jankralx/hapcan_cc_led_driver/docs/notes.md

final design should go with these components as find out on the prototype measurements:
- MSD1514-473MED Coilcraft common mode coils
- FDMS86252 as the tranzistor
- V3N103-M3/I as the main diode

however these components are for the parameters that were originally provided for the design without any specific tooling
there might be changes needed if the design parameters are changed or simulations show a different behaviour
