jankralx/hapcan_cc_led_driver/kicad/cc_led_driver_prototype/hapcan_cc_led_driver.csv

Id | Designator | Footprint | Quantity | Designation | Supplier and ref
1 | C1, C4, C6, C7, C11, C12 | C_1210_3225Metric | 6 | 4u7/100V KAM32LR72A475KU
2 | C2 | C_0805_2012Metric | 1 | 220n
3 | C3, C5, C13 | C_Elec_6.3x5.8 | 3 | 56uF/63V PCV1J5R6MCL1GS
4 | C8, C9 | C_1210_3225Metric | 2 | 1u/100V X7R
5 | C10 | C_Rect_L28.0mm_W10.0mm_P22.50mm_MKS4 | 1 | 10u/100V B32523Q1106K
6 | D1 | D_SMB | 1 | SM6T33A
7 | D2 | D_MiniMELF | 1 | BZV55B3V3
8 | D3 | TO-277A | 1 | MBR5H150PC-AU
9 | F1 | C_Disc_D9.0mm_W2.5mm_P5.00mm | 1 | 0ZRS0500FF1A
10 | J1, J3 | PhoenixContact_MSTBA_2,5_2-G-5,08_1x02_P5.08mm_Horizontal | 2 | Conn_01x02_Socket
11 | J2 | PinHeader_1x02_P2.54mm_Vertical | 1 | Conn_01x02_Socket
12 | L1 | L_CommonModeChoke_Bourns_SRF1260 | 1 | SRF1280A-470M
13 | Q1 | TO-252-2 | 1 | PJD45N15S-AU_L2_006A1
14 | R1, R5, R14 | R_0805_2012Metric | 3 | 12k
15 | R2 | R_0805_2012Metric | 1 | 2R2
16 | R3, R4, R10 | R_1210_3225Metric_Pad1.30x2.65mm_HandSolder | 3 | 0R
17 | R6 | R_0805_2012Metric | 1 | 5R6
18 | R7, R11 | R_0805_2012Metric | 2 | 0R
19 | R8, R9 | R_1206_3216Metric | 2 | 150m
20 | R12 | R_0805_2012Metric | 1 | 160k
21 | R13 | R_0805_2012Metric | 1 | 270k
22 | R15, R16 | R_1206_3216Metric | 2 | 0R56
23 | U1 | SO-8_3.9x4.9mm_P1.27mm | 1 | AL8853AQ
