jankralx/hapcan_cc_led_driver/kicad/cc_led_driver_prototype/hapcan_cc_led_driver.kicad_pcb

## KiCad design kicad/cc_led_driver_prototype/hapcan_cc_led_driver.kicad_pcb (2026-09-30)

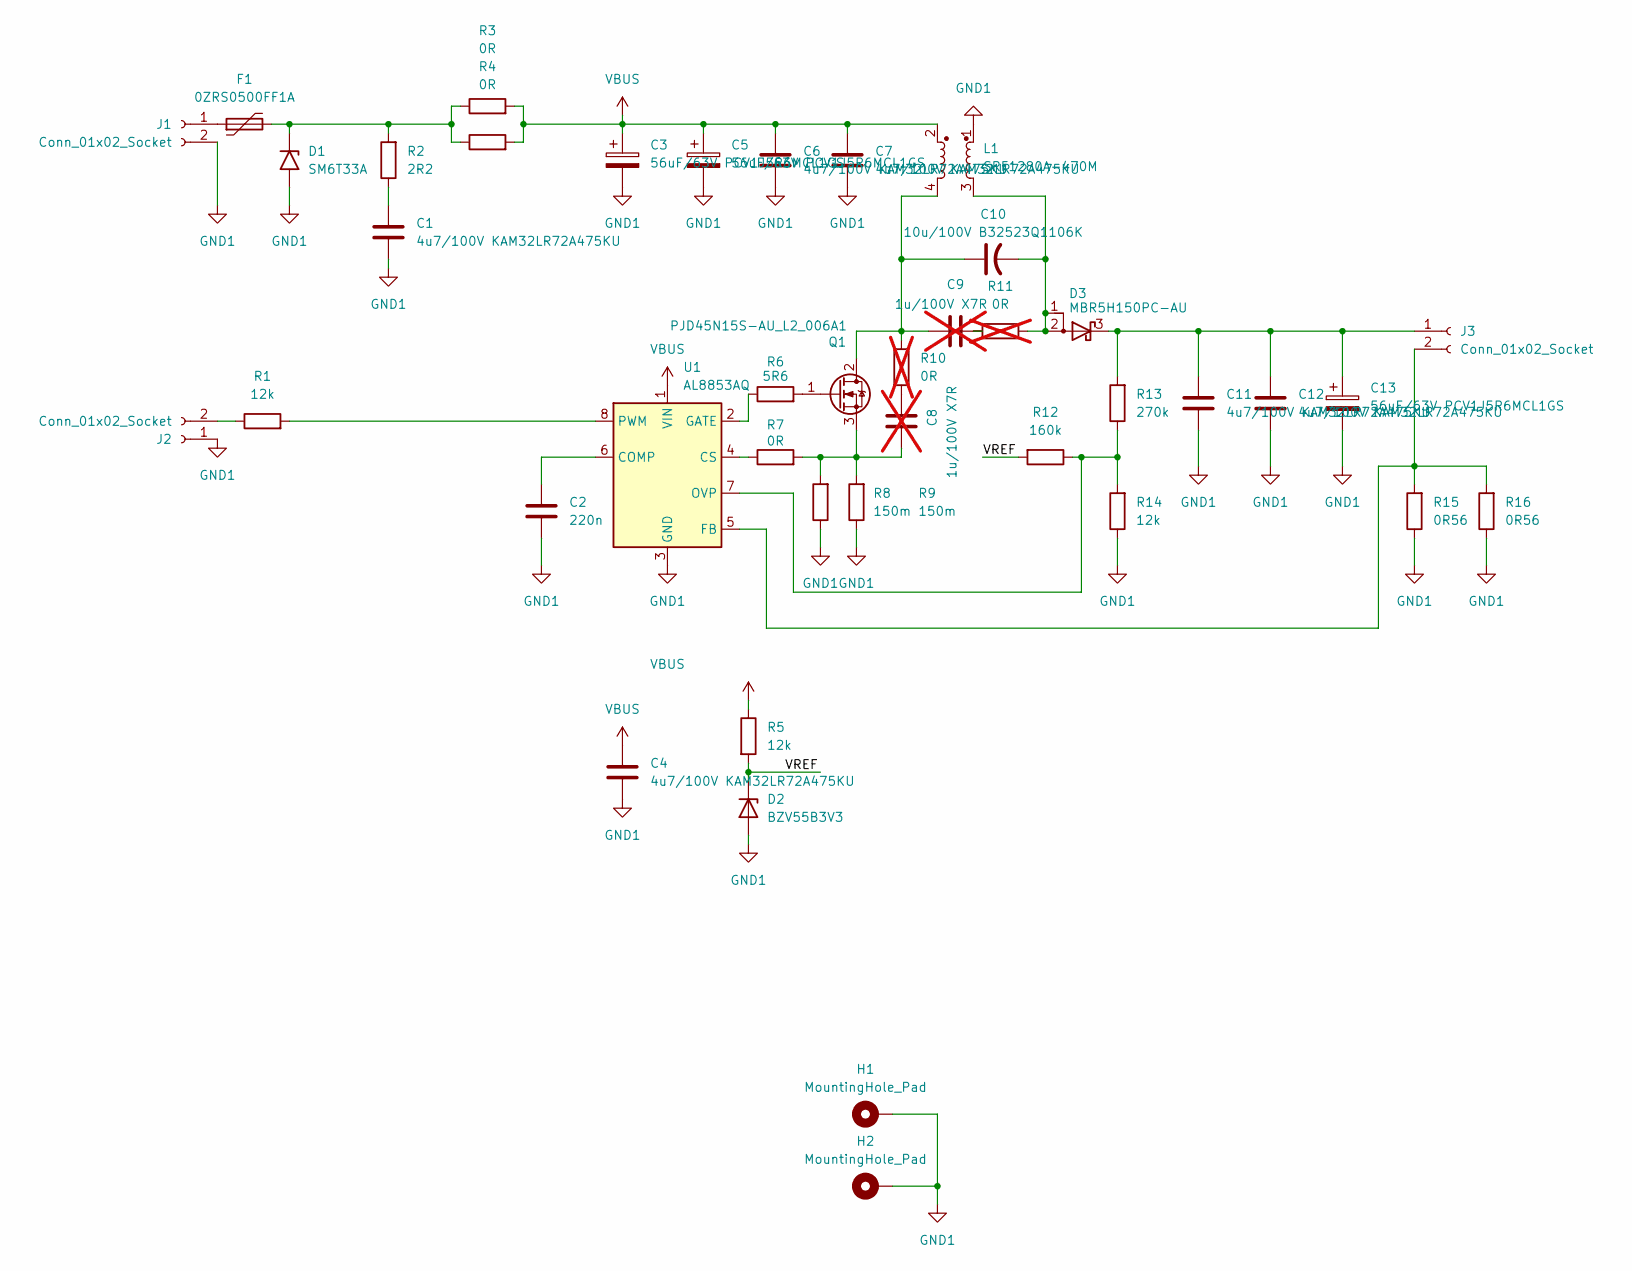
[picture p1: schematic hapcan_cc_led_driver.kicad_sch]

Parts:
C1, C4, C6, C7, C11, C12: 4u7/100V KAM32LR72A475KU; C_1210_3225Metric
C2: 220n; C_0805_2012Metric
C3, C5, C13: 56uF/63V PCV1J5R6MCL1GS; C_Elec_6.3x5.8
C8, C9: 1u/100V X7R; C_1210_3225Metric; not fitted
C10: 10u/100V B32523Q1106K; C_Rect_L28.0mm_W10.0mm_P22.50mm_MKS4
D1: SM6T33A; D_SMB
D2: BZV55B3V3; D_MiniMELF
D3: MBR5H150PC-AU; TO-277A
F1: 0ZRS0500FF1A; C_Disc_D9.0mm_W2.5mm_P5.00mm
H1, H2: MountingHole_Pad; MountingHole_3.2mm_M3_Pad_Via
J1, J3: Conn_01x02_Socket; PhoenixContact_MSTBA_2,5_2-G-5,08_1x02_P5.08mm_Horizontal
J2: Conn_01x02_Socket; PinHeader_1x02_P2.54mm_Vertical
L1: SRF1280A-470M; L_CommonModeChoke_Bourns_SRF1260
Q1: PJD45N15S-AU_L2_006A1; TO-252-2
R1, R5, R14: 12k; R_0805_2012Metric
R2: 2R2; R_0805_2012Metric
R3, R4: 0R; R_1210_3225Metric_Pad1.30x2.65mm_HandSolder
R6: 5R6; R_0805_2012Metric
R7: 0R; R_0805_2012Metric
R8, R9: 150m; R_1206_3216Metric
R10: 0R; R_1210_3225Metric_Pad1.30x2.65mm_HandSolder; not fitted
R11: 0R; R_0805_2012Metric; not fitted
R12: 160k; R_0805_2012Metric
R13: 270k; R_0805_2012Metric
R15, R16: 0R56; R_1206_3216Metric
U1: AL8853AQ; SO-8_3.9x4.9mm_P1.27mm

Connections:
/VREF: D2.1 (K), R5.2, R12.2
GND1: C1.2, C2.2, C3.2, C4.2, C5.2, C6.2, C7.2, C11.2, C12.2, C13.2, D1.2 (A2), D2.2 (A), H1.1 (1_1), H2.1, J1.2, J2.1, L1.1, R8.1, R9.1, R14.1, R15.1, R16.1, U1.3 (GND)
unnamed: C1.1, R2.1
unnamed: C8.2, R10.2
unnamed: C9.2, R11.2
unnamed: C10.2, D3.1 (A), D3.2 (A), L1.3, R11.1
unnamed: D1.1 (A1), F1.2, R2.2, R3.1, R4.1
unnamed: C11.1, C12.1, C13.1, D3.3 (K), J3.1, R13.2
unnamed: F1.1, J1.1
unnamed: J2.2, R1.1
unnamed: J3.2, R15.2, R16.2, U1.5 (FB)
unnamed: C9.1, C10.1, L1.4, Q1.2 (D), R10.1
unnamed: Q1.1 (G), R6.2
unnamed: C8.1, Q1.3 (S), R7.2, R8.2, R9.2
unnamed: C2.1, U1.6 (COMP)
unnamed: R7.1, U1.4 (CS)
unnamed: R6.1, U1.2 (GATE)
unnamed: R12.1, R13.1, R14.2, U1.7 (OVP)
unnamed: R1.2, U1.8 (PWM)
VBUS: C3.1, C4.1, C5.1, C6.1, C7.1, L1.2, R3.2, R4.2, R5.1, U1.1 (VIN)

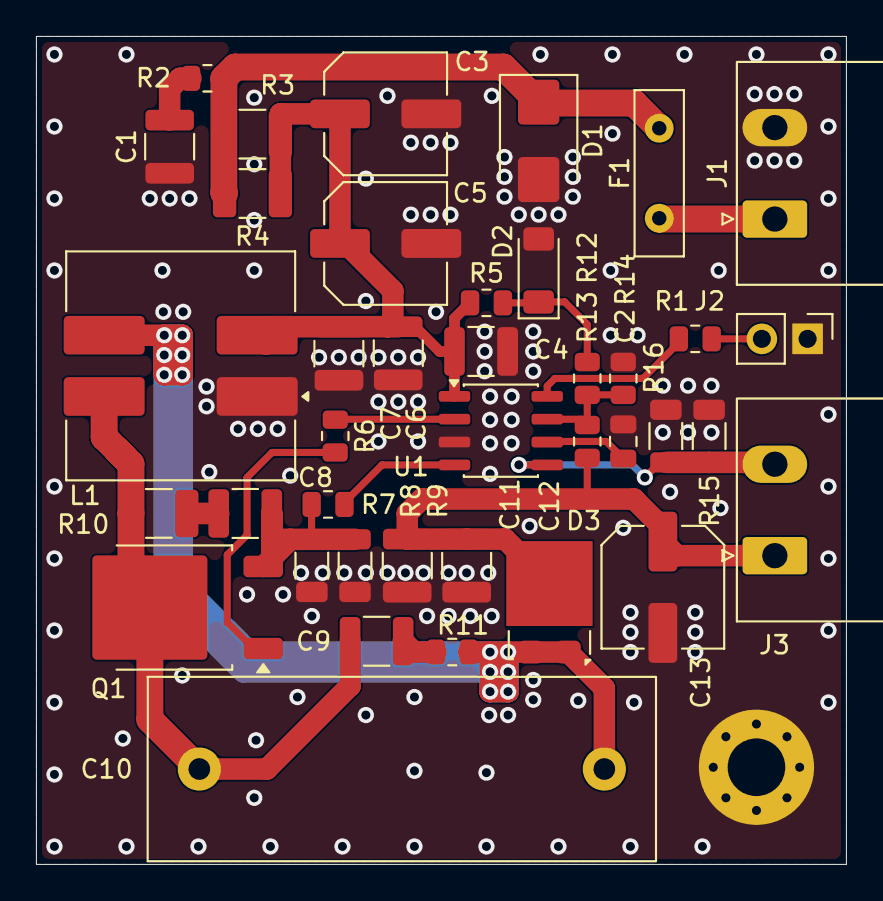
[picture p2: board hapcan_cc_led_driver.kicad_pcb from above]

Board: 4 copper layers, 45.0 x 46.0 mm, 40 parts (0 on the bottom side), 20 nets.
