jankralx/hapcan_cc_led_driver/docs/prototype_power_efficiency_measuremenets.ods

Rout [Ohm] | Uin [V] | Iin [mA] | Vout [V] | Iout [mA] | Pin [W] | Pout [W] | N [%]
20 | 21.5 | 62 | 3.75 | 198 | 1.333 | 0.7425 | 55.7 %
20 | 21.4 | 126 | 6.5 | 302 | 2.6964 | 1.963 | 72.8 %
20 | 21.2 | 237 | 9.66 | 420 | 5.0244 | 4.0572 | 80.7 %
20 | 20.95 | 456 | 13.98 | 582 | 9.5532 | 8.13636 | 85.2 %
20 | 20.11 | 625 | 16.52 | 678 | 12.56875 | 11.20056 | 89.1 %
30 | 21.47 | 84 | 6.09 | 191 | 1.80348 | 1.16319 | 64.5 %
30 | 21.28 | 191 | 10.59 | 303 | 4.06448 | 3.20877 | 78.9 %
30 | 20.97 | 442 | 17.09 | 466 | 9.26874 | 7.96394 | 85.9 %
30 | 20.49 | 774 | 20.45 | 678 | 15.85926 | 13.8651 | 87.4 %
46 | 21.6 | 82 | 7.41 | 146 | 1.7712 | 1.08186 | 61.1 %
46 | 21.33 | 189 | 13.18 | 240 | 4.03137 | 3.1632 | 78.5 %
46 | 20.77 | 567 | 21.74 | 472 | 11.77659 | 10.26128 | 87.1 %
46 | 23.76 | 1033 | 31.28 | 679 | 24.54408 | 21.23912 | 86.5 %
 |  |  |  |  | 0 | 0 | #DIV/0!
 |  |  |  |  | 0 | 0 | #DIV/0!
30 | 23.8 | 660 | 20.38 | 680 | 15.708 | 13.8584 | 88.2 %
45 | 23.68 | 980 | 30.38 | 670 | 23.2064 | 20.3546 | 87.7 %
 |  |  |  |  | 0 | 0 | #DIV/0!
 |  |  |  |  | 0 | 0 | #DIV/0!
 |  |  |  |  | 0 | 0 | #DIV/0!
 |  |  |  |  | 0 | 0 | #DIV/0!
 |  |  |  |  | 0 | 0 | #DIV/0!
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
